LIPISMIES/OmaTyo_SYNTIKKA_MELODIA/HW/melodiasekvensseri.csv

Reference | Qty | Value | DNP | Exclude from BOM | Exclude from Board | Exclude from Simulation | Exclude from Position Files | Footprint | Datasheet
C1 | 1 | 10u |  |  |  |  | ${EXCLUDE_FROM_POS_FILES} | Capacitor_THT:CP_Radial_D5.0mm_P2.00mm
C3,C6,C9,C10,C13,C14,C15 | 7 | 100n |  |  |  |  | ${EXCLUDE_FROM_POS_FILES} | Capacitor_THT:C_Disc_D5.0mm_W2.5mm_P5.00mm
C5 | 1 | 330n |  |  |  |  | ${EXCLUDE_FROM_POS_FILES} | Capacitor_THT:C_Disc_D5.0mm_W2.5mm_P5.00mm
C7,C8 | 2 | 10u |  |  |  |  | ${EXCLUDE_FROM_POS_FILES} | Capacitor_THT:C_Disc_D5.0mm_W2.5mm_P5.00mm
C11,C12 | 2 | 10n |  |  |  |  | ${EXCLUDE_FROM_POS_FILES} | Capacitor_THT:C_Disc_D5.0mm_W2.5mm_P5.00mm
D1 | 1 | 1N5817 |  |  |  |  | ${EXCLUDE_FROM_POS_FILES} | Diode_THT:D_DO-41_SOD81_P10.16mm_Horizontal | http://www.vishay.com/docs/88525/1n5817.pdf
D3 | 1 | 1N4733A |  |  |  |  | ${EXCLUDE_FROM_POS_FILES} | Diode_THT:D_DO-41_SOD81_P10.16mm_Horizontal | https://www.vishay.com/docs/85816/1n4728a.pdf
DAC1 | 1 | MCP4821-E_P |  |  |  |  | ${EXCLUDE_FROM_POS_FILES} | Project_Libraries:DIP794W53P254L959H508Q8N | https://componentsearchengine.com/Datasheets/2/MCP4821-E_P.pdf
IC1 | 1 | 74LS138 |  |  |  |  | ${EXCLUDE_FROM_POS_FILES} | Package_DIP:DIP-16_W7.62mm | http://www.ti.com/lit/gpn/sn74LS138
J1 | 1 | Conn_02x05_Odd_Even |  |  |  | Excluded from simulation | ${EXCLUDE_FROM_POS_FILES} | Connector_IDC:IDC-Header_2x05_P2.54mm_Vertical
J2 | 1 | Clock_In |  |  |  |  | ${EXCLUDE_FROM_POS_FILES} | Project_Libraries:Adafruit_BBF_3_5mm_Mono_Jack
J3 | 1 | Gate_Out |  |  |  |  | ${EXCLUDE_FROM_POS_FILES} | Project_Libraries:Adafruit_BBF_3_5mm_Mono_Jack
J4 | 1 | CV_Out |  |  |  |  | ${EXCLUDE_FROM_POS_FILES} | Project_Libraries:Adafruit_BBF_3_5mm_Mono_Jack
J5 | 1 | Conn_02x03_Odd_Even |  |  |  |  | ${EXCLUDE_FROM_POS_FILES} | Connector_PinHeader_2.54mm:PinHeader_2x03_P2.54mm_Vertical
J6 | 1 | Conn_01x04 |  |  |  |  | ${EXCLUDE_FROM_POS_FILES} | Connector_PinHeader_2.54mm:PinHeader_1x04_P2.54mm_Vertical
MC1 | 1 | ATmega328P-P |  |  |  |  | ${EXCLUDE_FROM_POS_FILES} | Package_DIP:DIP-28_W7.62mm | http://ww1.microchip.com/downloads/en/DeviceDoc/ATmega328_P%20AVR%20MCU%20with%20picoPower%20Technology%20Data%20Sheet%2040001984A.pdf
R1,R8 | 2 | 10 |  |  |  |  | ${EXCLUDE_FROM_POS_FILES} | Resistor_THT:R_Axial_DIN0207_L6.3mm_D2.5mm_P10.16mm_Horizontal
R3 | 1 | 330 |  |  |  |  | ${EXCLUDE_FROM_POS_FILES} | Resistor_THT:R_Axial_DIN0207_L6.3mm_D2.5mm_P10.16mm_Horizontal
R4,R5,R6 | 3 | 1k |  |  |  |  | ${EXCLUDE_FROM_POS_FILES} | Resistor_THT:R_Axial_DIN0207_L6.3mm_D2.5mm_P10.16mm_Horizontal
R7 | 1 | 10k |  |  |  |  | ${EXCLUDE_FROM_POS_FILES} | Resistor_THT:R_Axial_DIN0207_L6.3mm_D2.5mm_P10.16mm_Horizontal
RE1 | 1 | EC11E15244B2 |  |  |  |  | ${EXCLUDE_FROM_POS_FILES} | Project_Libraries:EC11E15244B2 | https://tech.alpsalpine.com/e/products/detail/EC11E15244B2/
REG1 | 1 | LM78M05 |  |  |  |  | ${EXCLUDE_FROM_POS_FILES} | Package_TO_SOT_THT:TO-220-3_Vertical | https://www.onsemi.com/pub/Collateral/MC78M00-D.PDF
REG2 | 1 | MCP1700-5002E_TO |  |  |  |  | ${EXCLUDE_FROM_POS_FILES} | Project_Libraries:TO127P254X495-3
S1,S2,S3,S4,S5,S6,S7,S8 | 8 | TL1265RQSCLR |  |  |  |  | ${EXCLUDE_FROM_POS_FILES} | Project_Libraries:TL1265RQSCLR | https://configured-product-images.s3.amazonaws.com/2D/specs/TL1275CA2WA500QPB.pdf
S9 | 1 | TS02-66-140-BK-160-LCR-D |  |  |  |  | ${EXCLUDE_FROM_POS_FILES} | Project_Libraries:TS0266100BK100LCRD | https://www.sameskydevices.com/product/resource/ts02.pdf
TP_12V1,TP_A5V1,TP_D5V1,TP_DGND1 | 4 | TestPoint |  |  |  |  | ${EXCLUDE_FROM_POS_FILES} | TestPoint:TestPoint_Pad_2.0x2.0mm
TP_AGND1,TP_CV_OUT1 | 2 | TestPoint |  |  |  |  | ${EXCLUDE_FROM_POS_FILES} | TestPoint:TestPoint_THTPad_2.0x2.0mm_Drill1.0mm
U1 | 1 | TLV2372IP |  |  |  |  | ${EXCLUDE_FROM_POS_FILES} | Project_Libraries:DIP794W53P254L959H508Q8N | https://datasheet.datasheetarchive.com/originals/distributors/Datasheets-SFU2/DSASFU100032270.pdf
VR1 | 1 | 3296W-1-103 |  |  |  |  | ${EXCLUDE_FROM_POS_FILES} | Project_Libraries:3296W1103 | https://www.bourns.com/data/global/pdfs/3296.pdf
VR2 | 1 | PTV09A-4025F-B103 |  |  |  |  | ${EXCLUDE_FROM_POS_FILES} | Project_Libraries:PTV09A4025FB103 | https://www.bourns.com/docs/Product-Datasheets/PTV09.pdf
