LIPISMIES/OmaTyo_SYNTIKKA_MELODIA/HW/Front_Panel_v1.stl

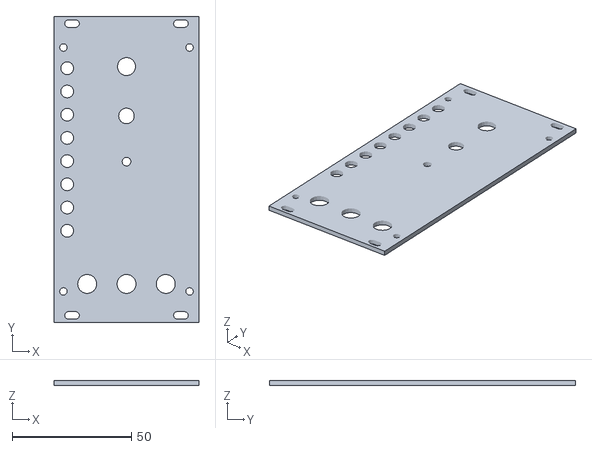
[picture p1: CAD file, 2026-10-16]
HW/Front_Panel_v1.stl
60.7 x 128.5 x 2.00
