LIPISMIES/OmaTyo_SYNTIKKA_MELODIA/HW/Project_Libraries/3D_Models/3296W-1-103.stp

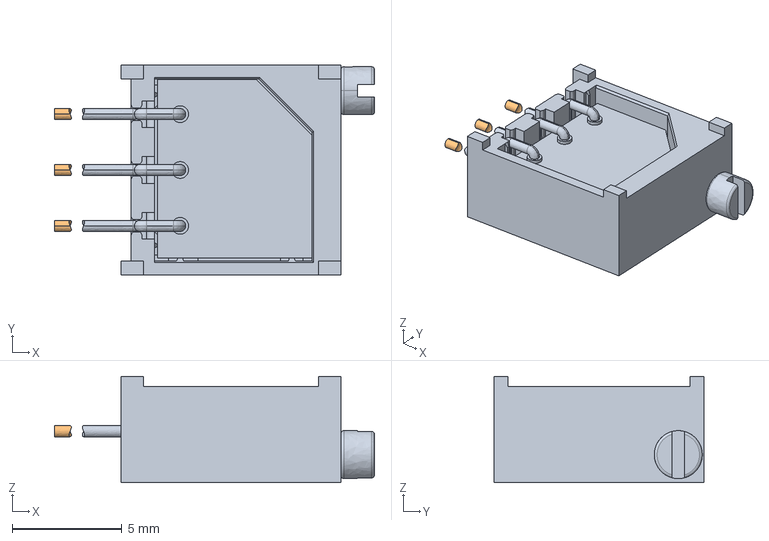
[picture p2: CAD file, 2026-10-11]
HW/Project_Libraries/3D_Models/3296W-1-103.stp
14.6 x 9.55 x 4.83 mm
