LIPISMIES/OmaTyo_SYNTIKKA_MELODIA/HW/Project_Libraries/EC11E15244B2.stp

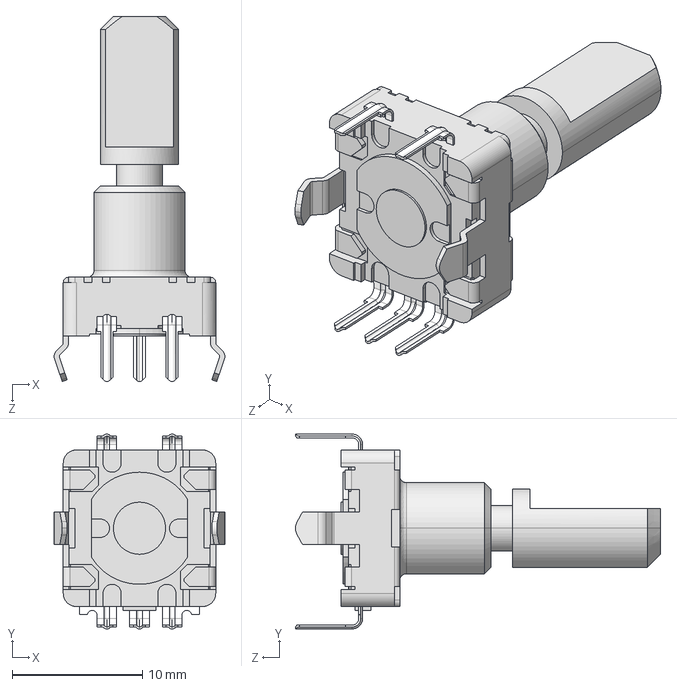
[picture p3: CAD file, 2026-10-11]
HW/Project_Libraries/EC11E15244B2.stp
13.1 x 15.0 x 28.0 mm
