LIPISMIES/OmaTyo_SYNTIKKA_MELODIA/HW/melodiasekvensseri.step

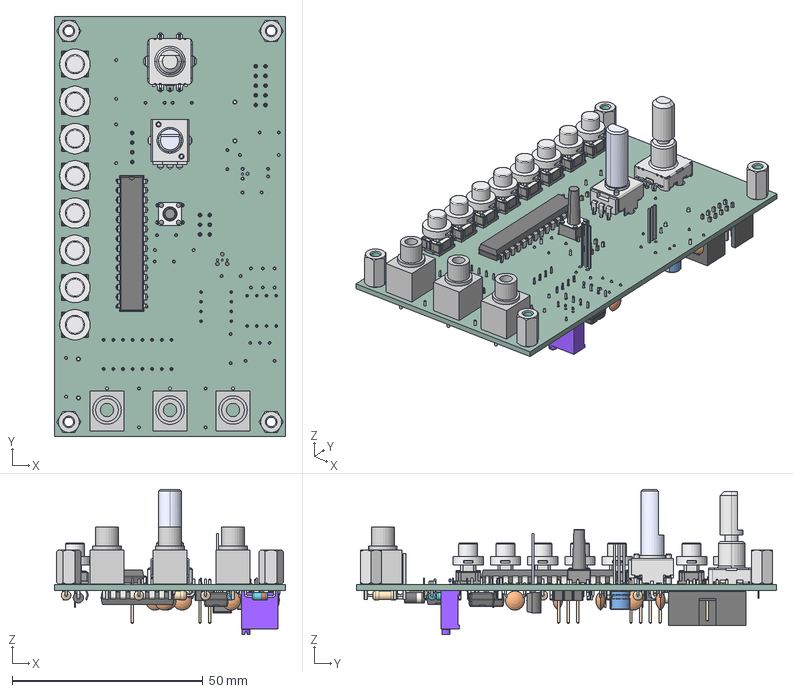
[picture p4: CAD file, 2026-10-13]
HW/melodiasekvensseri.step
60.6 x 110.0 x 38.1 mm
TL1265 Housing x 8
TL1265 Plunger x 8
TL1265 Cover x 8
TL1265 TWIST LED x 8
TL1265 S Cap Clear x 8
adafruitjack v1 x 3
EC11E-15SW
DIP-28_W7.62mm
CUI_DEVICES_TS02-66-140-BK-160-LCR-D
R_Axial_DIN0207_L63mm_D25mm_P1016mm_Horizontal x 7
IDC_Header_2x05_P254mm_Vertical
C_Disc_D50mm_W25mm_P500mm x 11
D_DO-35_SOD27_P7.62mm_Horizontal x 2
TS110-7A1-AP_Bulk Pack (Straight)
STMicro Logo
DIP-16_W7.62mm
BODY_P0008A x 2
LEAD_P0008A x 8
LD_LHALF_P0008A x 4
LD_RHALF_P0008A x 4
D_DO-41_SOD81_P10.16mm_Horizontal x 2
PinHeader_1x04_P254mm_Vertical
3296w-1-503lf_1
3296w-1-503lf_2
3296w-1-503lf_3
3296w-1-503lf_4
PinHeader_2x03_P254mm_Vertical
CP_Radial_D50mm_P200mm
2N7000-G
melodiasekvensseri_PCB
