LIPISMIES/OmaTyo_SYNTIKKA_MELODIA/HW/Project_Libraries/3D_Models/L78L05ACZ.stp

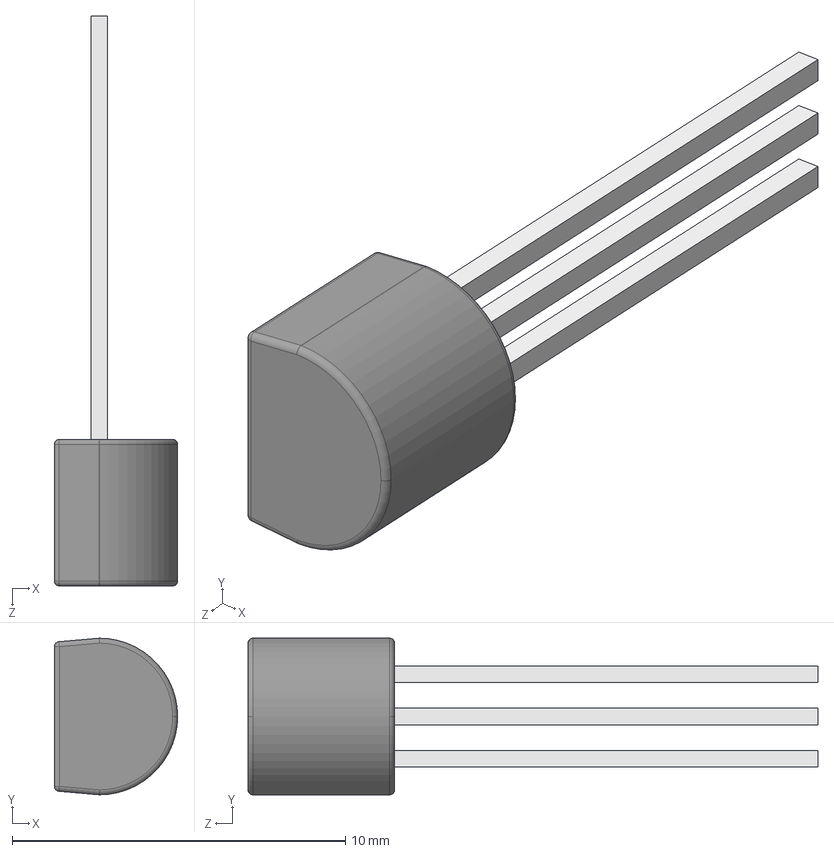
[picture p5: CAD file, 2026-10-11]
HW/Project_Libraries/3D_Models/L78L05ACZ.stp
3.70 x 4.70 x 17.1 mm
TS110-7A1-AP_Bulk Pack (Straight)
STMicro Logo
