LIPISMIES/OmaTyo_SYNTIKKA_MELODIA/HW/Project_Libraries/3D_Models/TS02-66-140-BK-160-LCR-D.stp

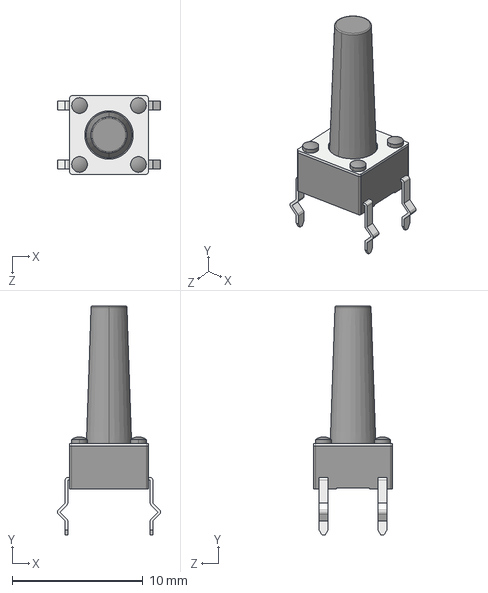
[picture p6: CAD file, 2026-10-11]
HW/Project_Libraries/3D_Models/TS02-66-140-BK-160-LCR-D.stp
7.90 x 17.5 x 6.00 mm
