LIPISMIES/OmaTyo_SYNTIKKA_MELODIA/HW/Project_Libraries/3D_Models/PTV09A-4025F-B103.stp

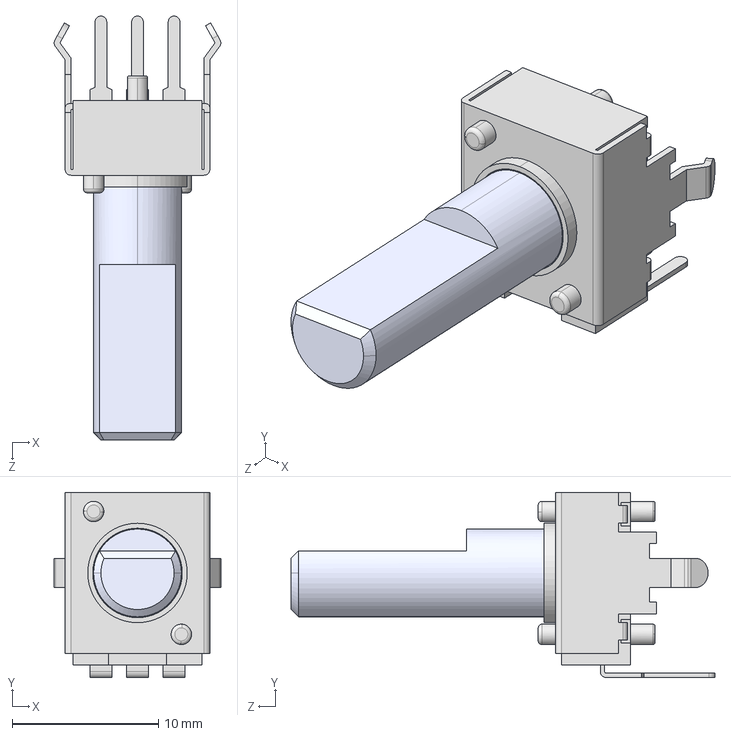
[picture p7: CAD file, 2026-10-11]
HW/Project_Libraries/3D_Models/PTV09A-4025F-B103.stp
11.4 x 12.7 x 29.0 mm
