LIPISMIES/OmaTyo_SYNTIKKA_MELODIA/HW/Project_Libraries/3D_Models/Download_STEP_970090324+(rev1).stp

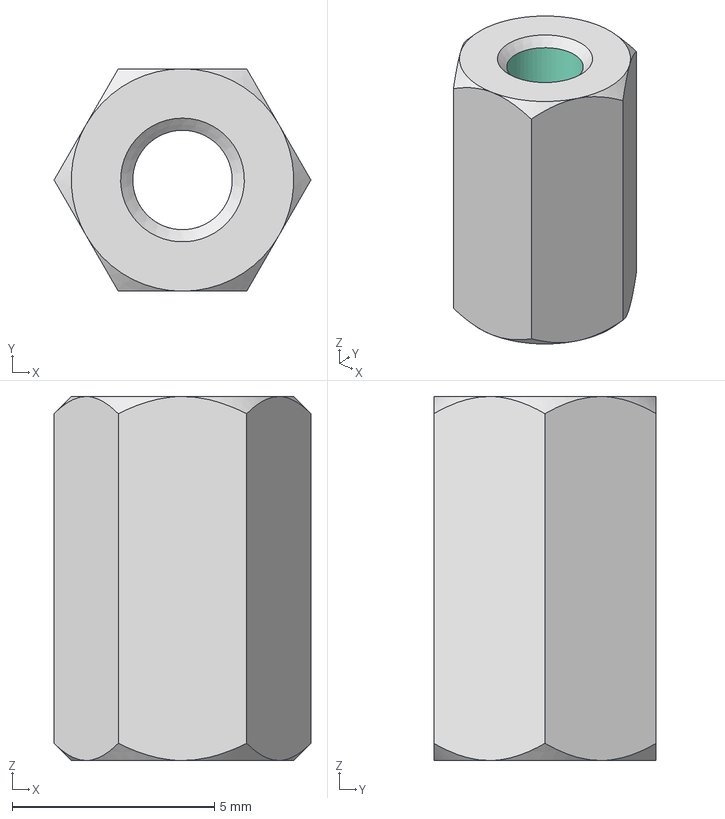
[picture p8: CAD file, 2026-10-11]
HW/Project_Libraries/3D_Models/Download_STEP_970090324+(rev1).stp
6.35 x 5.50 x 9.00 mm
