LIPISMIES/OmaTyo_SYNTIKKA_MELODIA/HW/Project_Libraries/3D_Models/MCP4821-E_P.stp

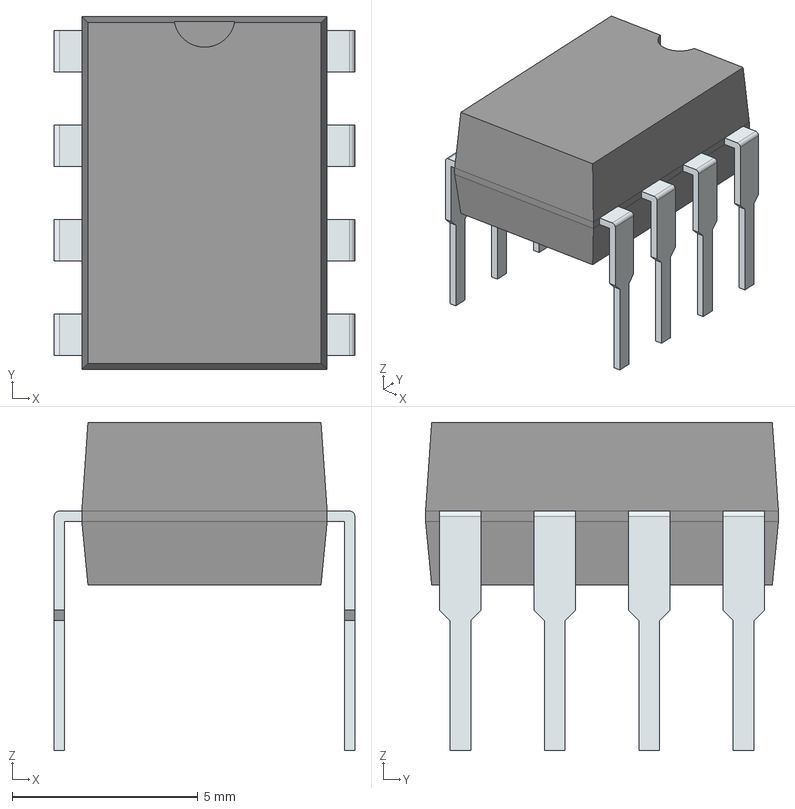
[picture p9: CAD file, 2026-10-11]
HW/Project_Libraries/3D_Models/MCP4821-E_P.stp
8.09 x 9.50 x 8.83 mm
PinsArrayLR
