LIPISMIES/OmaTyo_SYNTIKKA_MELODIA/HW/Project_Libraries/3D_Models/TL1265xQSxxx.stp

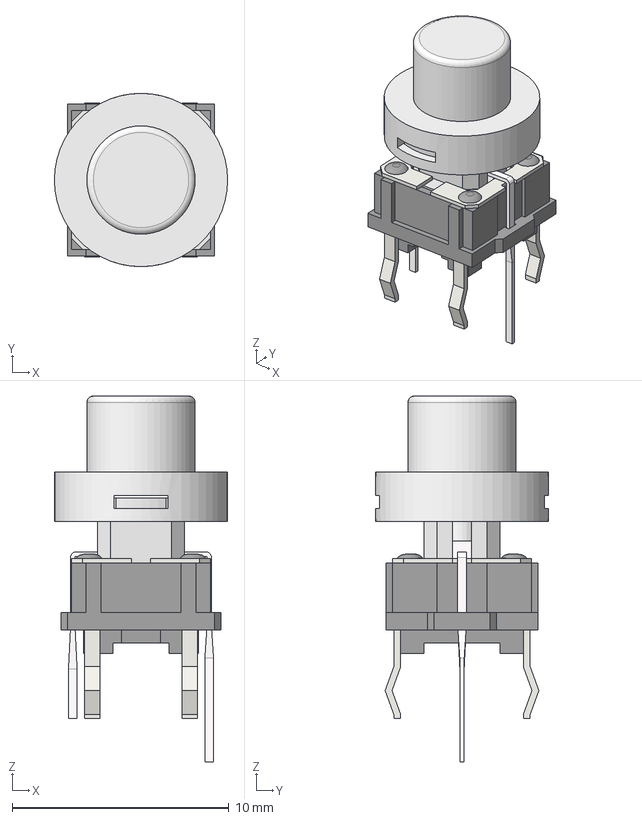
[picture p10: CAD file, 2026-10-11]
HW/Project_Libraries/3D_Models/TL1265xQSxxx.stp
8.00 x 8.00 x 16.9 mm
TL1265 Housing
TL1265 Plunger
TL1265 Cover
TL1265 TWIST LED
TL1265 S Cap Clear
