LIPISMIES/OmaTyo_SYNTIKKA_MELODIA/HW/Project_Libraries/3D_Models/adafruitjack.step

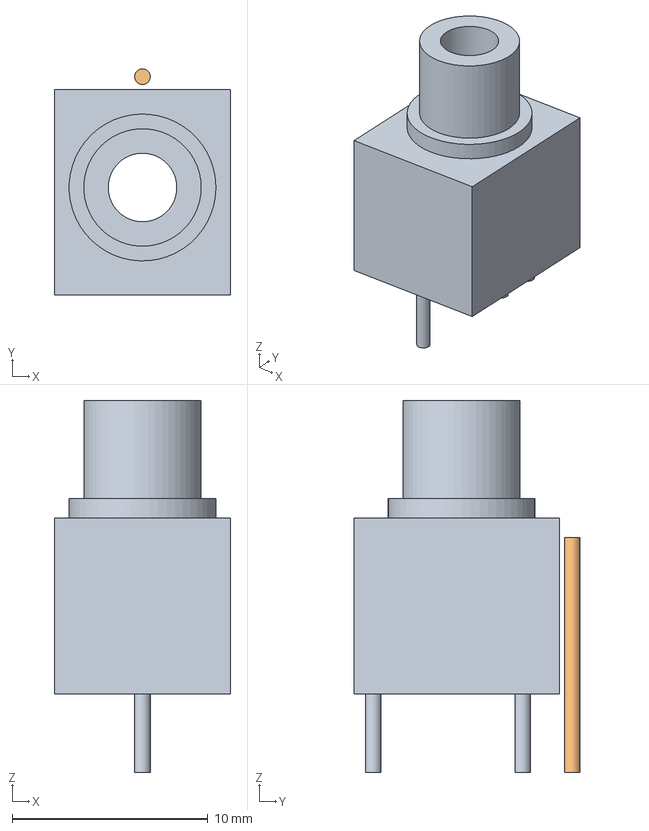
[picture p11: CAD file, 2026-10-11]
HW/Project_Libraries/3D_Models/adafruitjack.step
9.00 x 11.6 x 19.0 mm
