LIPISMIES/OmaTyo_SYNTIKKA_MELODIA/HW/Project_Libraries/3D_Models/TL1265RQSCLR.stp

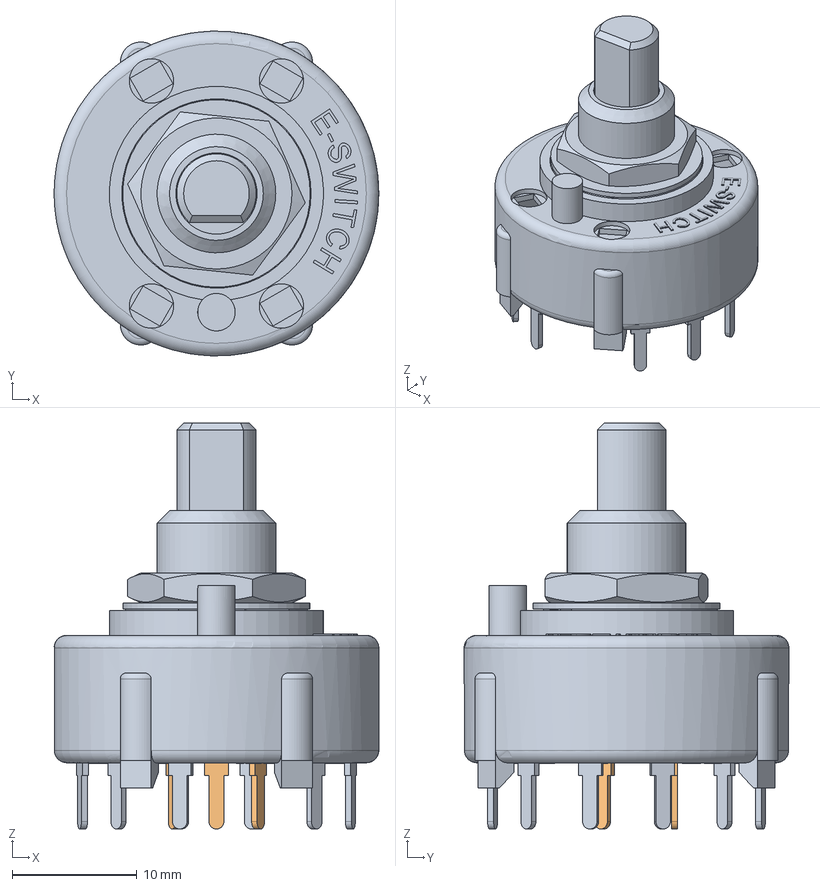
[picture p12: CAD file, 2026-10-11]
HW/Project_Libraries/3D_Models/TL1265RQSCLR.stp
26.0 x 26.0 x 32.5 mm
