LIPISMIES/OmaTyo_SYNTIKKA_MELODIA/HW/melodiasekvensseri.kicad_pcb

## KiCad design HW/melodiasekvensseri.kicad_pcb (2026-10-23)

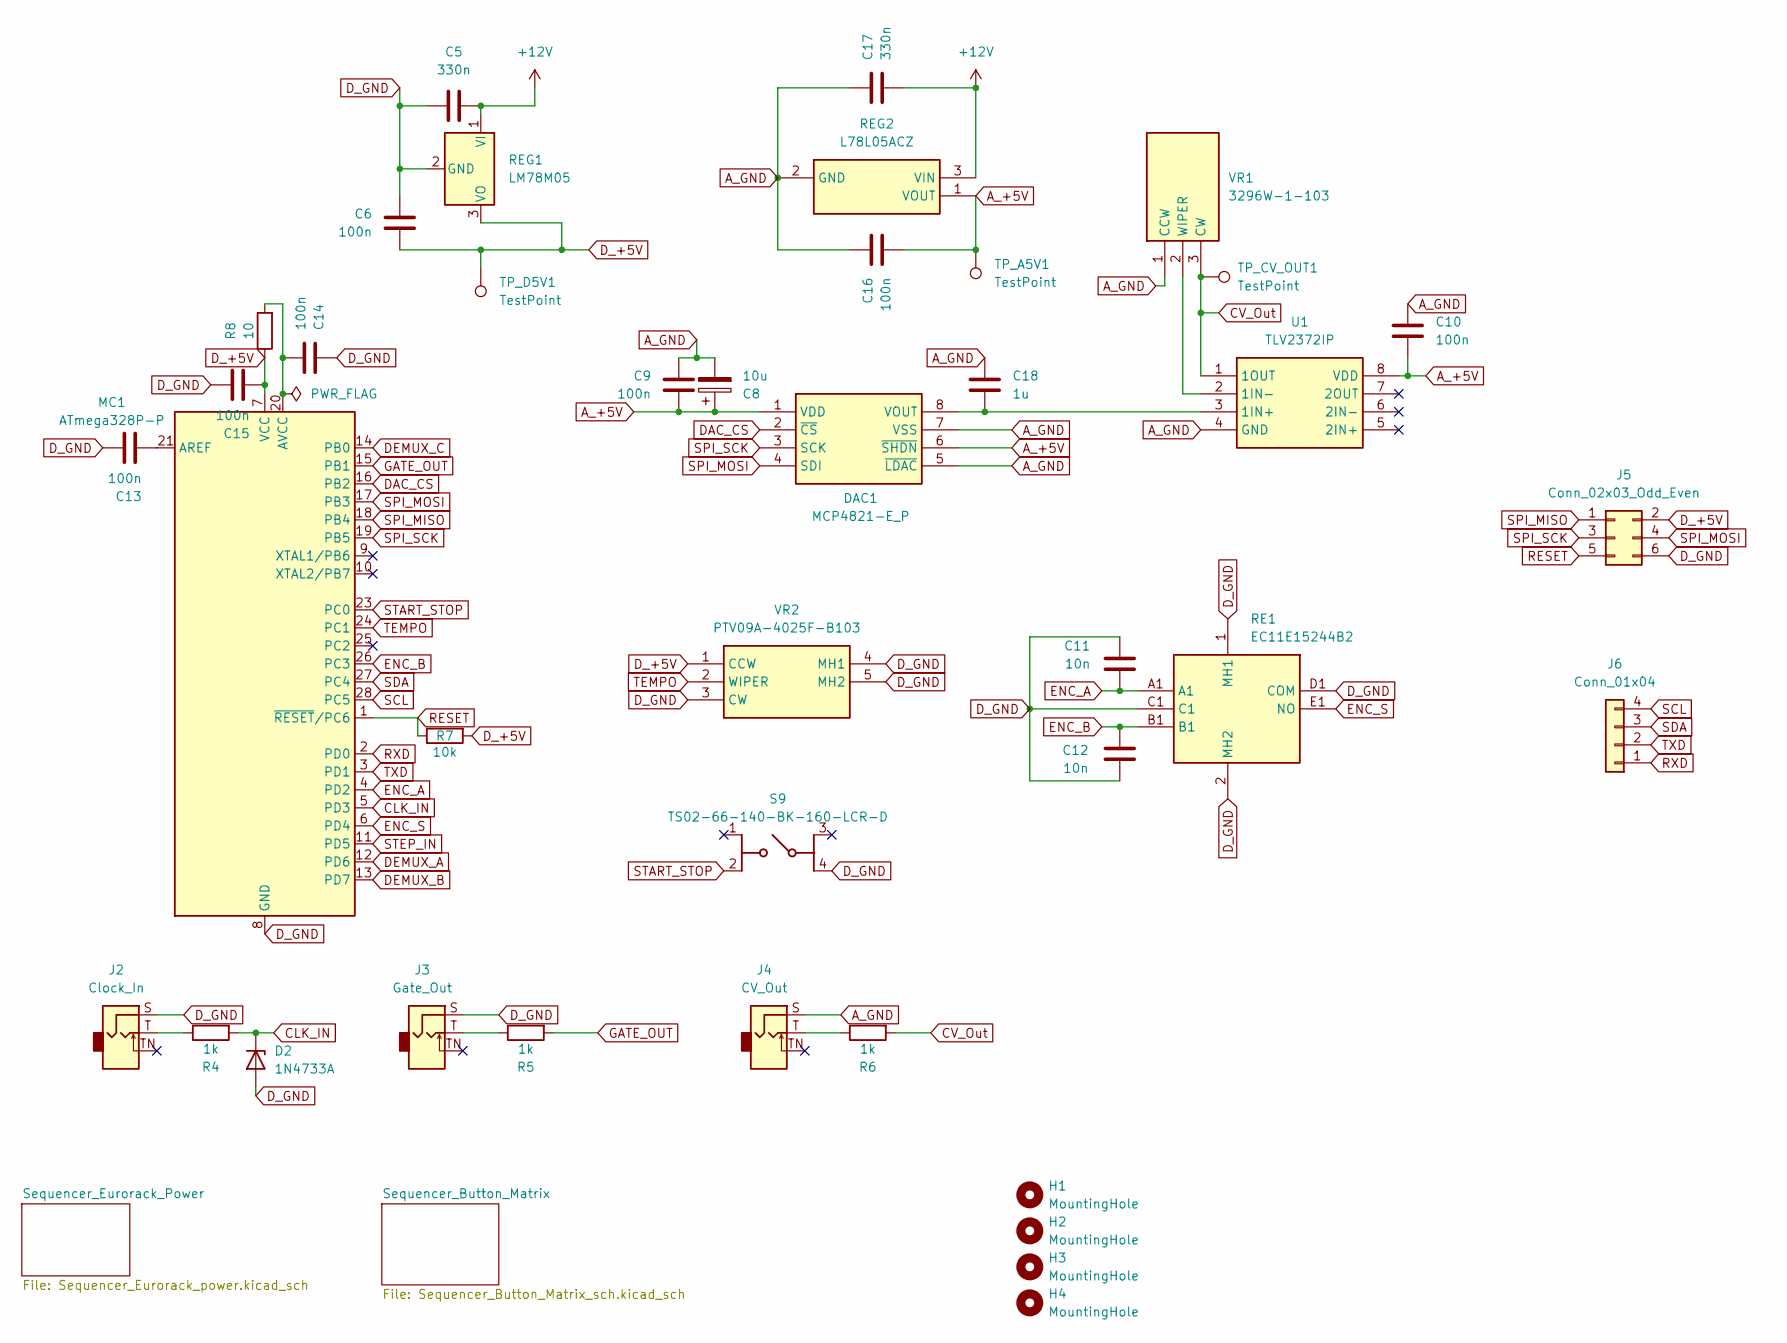
[picture p13: schematic melodiasekvensseri.kicad_sch]

Parts:
C5, C17: 330n; C_Disc_D5.0mm_W2.5mm_P5.00mm
C6, C9, C10, C13, C14, C15, C16: 100n; C_Disc_D5.0mm_W2.5mm_P5.00mm
C8: 10u; C_Disc_D5.0mm_W2.5mm_P5.00mm
C11, C12: 10n; C_Disc_D5.0mm_W2.5mm_P5.00mm
C18: 1u; C_Disc_D5.0mm_W2.5mm_P5.00mm
D2: 1N4733A; D_DO-41_SOD81_P10.16mm_Horizontal
DAC1: MCP4821-E_P; DIP794W53P254L959H508Q8N; Mouser Part Number 579-MCP4821-E/P
H1, H2, H3, H4: MountingHole; MountingHole_3.2mm_M3
J2: Clock_In; Adafruit_BBF_3_5mm_Mono_Jack
J3: Gate_Out; Adafruit_BBF_3_5mm_Mono_Jack
J4: CV_Out; Adafruit_BBF_3_5mm_Mono_Jack
J5: Conn_02x03_Odd_Even; PinHeader_2x03_P2.54mm_Vertical
J6: Conn_01x04; PinHeader_1x04_P2.54mm_Vertical
MC1: ATmega328P-P; DIP-28_W7.62mm
R4, R5, R6: 1k; Resistor_SMD+THTuniversal_0805to1206_RM10_HandSoldering_Rev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
R7: 10k; R_Axial_DIN0207_L6.3mm_D2.5mm_P10.16mm_Horizontal
R8: 10; R_Axial_DIN0207_L6.3mm_D2.5mm_P10.16mm_Horizontal
RE1: EC11E15244B2; Mouser Part Number 688-EC11E15244B2
REG1: LM78M05; TO-220-3_Vertical; Mouser Part Number 511-L78L05ACZ
REG2: L78L05ACZ; Mouser Part Number 511-L78L05ACZ
S9: TS02-66-140-BK-160-LCR-D; TS0266100BK100LCRD; Mouser Part Number 179-TS0266140BK160LC
TP_A5V1: TestPoint; TestPoint_THTPad_1.5x1.5mm_Drill0.7mm
TP_CV_OUT1: TestPoint; TestPoint_THTPad_1.5x1.5mm_Drill0.7mm
TP_D5V1: TestPoint; TestPoint_THTPad_1.5x1.5mm_Drill0.7mm
U1: TLV2372IP; DIP794W53P254L959H508Q8N; Mouser Part Number 595-TLV2372IP
VR1: 3296W-1-103; 3296W1103; Mouser Part Number 652-3296W-1-103
VR2: PTV09A-4025F-B103; PTV09A4025FB103; Mouser Part Number 652-PTV09A-4025FB103

Connections:
+12V: C5.2, C17.2, REG1.1 (VI), REG2.3 (VIN); also elsewhere on the board
A_+5V: C8.1, C9.2, C10.2, C16.2, DAC1.1 (VDD), DAC1.6 (~SHDN), REG2.1 (VOUT), TP_A5V1.1 (1_1), U1.8 (VDD)
A_GND: C8.2, C9.1, C10.1, C16.1, C17.1, C18.1, DAC1.5 (~LDAC), DAC1.7 (VSS), J4.S, REG2.2 (GND), U1.4 (GND), VR1.1 (CCW); also elsewhere on the board
CLK_IN: D2.1 (K), MC1.5 (PD3), R4.2
CV_Out: R6.2, TP_CV_OUT1.1 (1_1), U1.1 (1OUT), VR1.3 (CW)
DAC_CS: DAC1.2 (~CS), MC1.16 (PB2)
DEMUX_A: MC1.12 (PD6); also elsewhere on the board
DEMUX_B: MC1.13 (PD7); also elsewhere on the board
DEMUX_C: MC1.14 (PB0); also elsewhere on the board
D_+5V: C6.2, C15.2, J5.2, MC1.7 (VCC), R7.2, R8.1, REG1.3 (VO), TP_D5V1.1 (1_1), VR2.1 (CCW); also elsewhere on the board
D_GND: C5.1, C6.1, C11.1, C12.2, C13.1, C14.1, C15.1, D2.2 (A), J2.S, J3.S, J5.6, MC1.8 (GND), MC1.22 (GND), RE1.1 (MH1), RE1.2 (MH2), RE1.C1, RE1.D1 (COM), REG1.2 (GND), S9.4 (COM_2), VR2.3 (CW), VR2.4 (MH1), VR2.5 (MH2); also elsewhere on the board
ENC_A: C11.2, MC1.4 (PD2), RE1.A1
ENC_B: C12.1, MC1.26 (PC3), RE1.B1
ENC_S: MC1.6 (PD4), RE1.E1 (NO)
GATE_OUT: MC1.15 (PB1), R5.2
unnamed: C18.2, DAC1.8 (VOUT), U1.3 (1IN+)
unnamed: J2.T, R4.1
unnamed: J3.T, R5.1
unnamed: J4.T, R6.1
unnamed: C13.2, MC1.21 (AREF)
unnamed: C14.2, MC1.20 (AVCC), R8.2
unnamed: U1.2 (1IN-), VR1.2 (WIPER)
RESET: J5.5, MC1.1 (~RESET/PC6), R7.1
RXD: J6.1, MC1.2 (PD0)
SCL: J6.4, MC1.28 (PC5)
SDA: J6.3, MC1.27 (PC4)
SPI_MISO: J5.1, MC1.18 (PB4)
SPI_MOSI: DAC1.4 (SDI), J5.4, MC1.17 (PB3)
SPI_SCK: DAC1.3 (SCK), J5.3, MC1.19 (PB5)
START_STOP: MC1.23 (PC0), S9.2 (NO_2)
STEP_IN: MC1.11 (PD5); also elsewhere on the board
TEMPO: MC1.24 (PC1), VR2.2 (WIPER)
TXD: J6.2, MC1.3 (PD1)

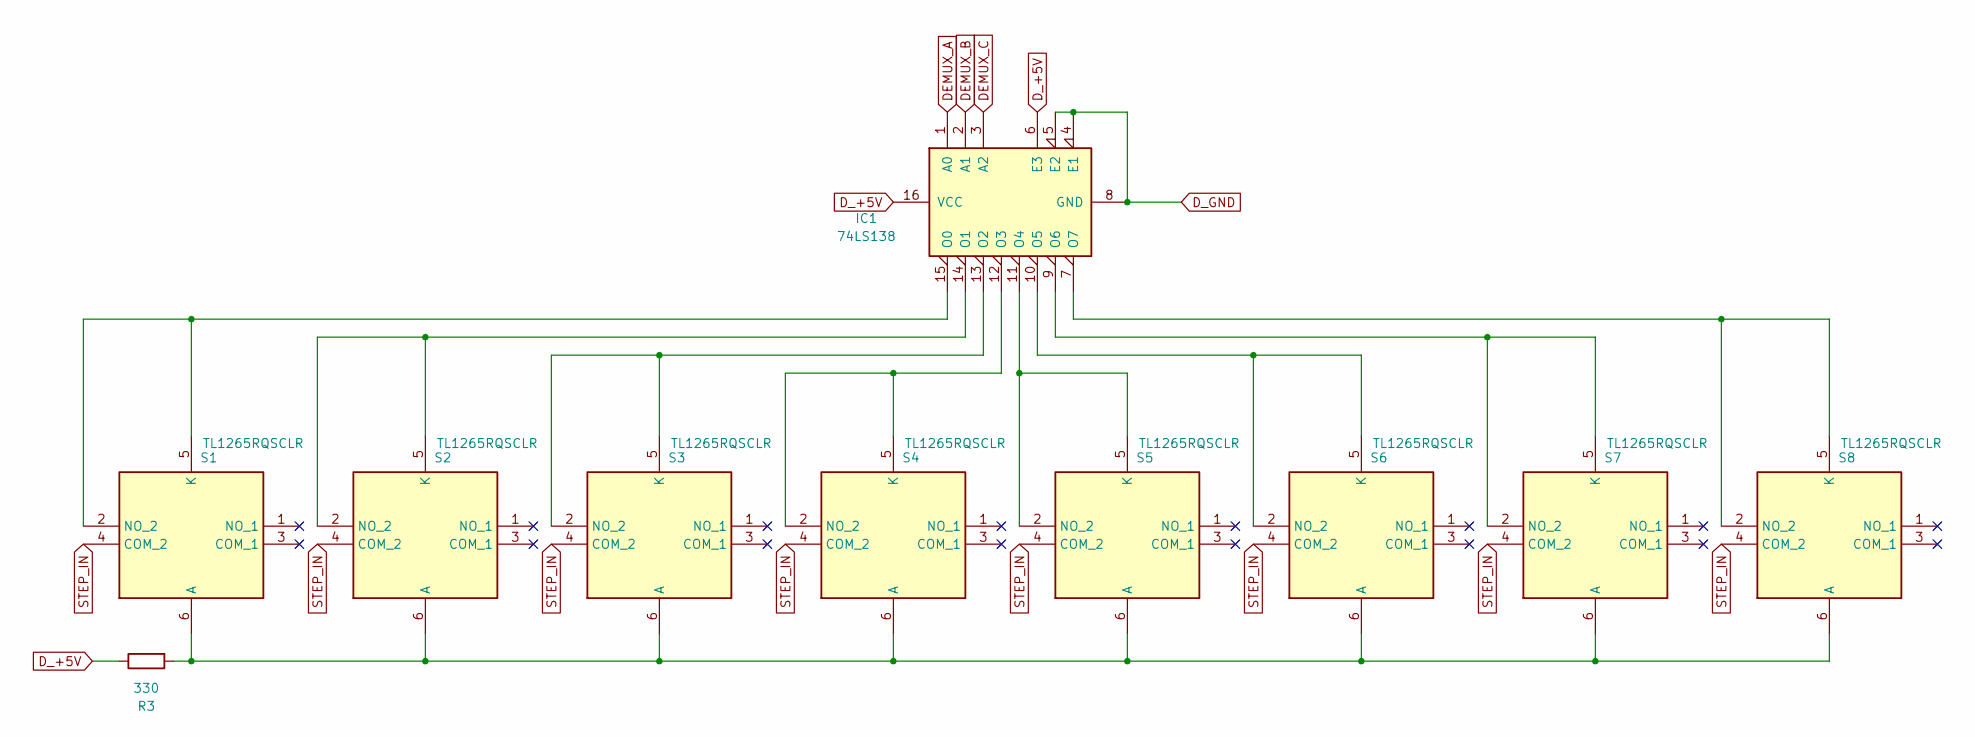
[picture p14: schematic Sequencer_Button_Matrix_sch.kicad_sch, Melodiasekvensseri]

Parts:
IC1: 74LS138; DIP-16_W7.62mm
R3: 330; R_Axial_DIN0207_L6.3mm_D2.5mm_P10.16mm_Horizontal
S1, S2, S3, S4, S5, S6, S7, S8: TL1265RQSCLR; Mouser Part Number 612-TL1265RQSCLR

Connections:
DEMUX_A: IC1.1 (A0); also elsewhere on the board
DEMUX_B: IC1.2 (A1); also elsewhere on the board
DEMUX_C: IC1.3 (A2); also elsewhere on the board
D_+5V: IC1.6 (E3), IC1.16 (VCC), R3.1; also elsewhere on the board
D_GND: IC1.4 (E1), IC1.5 (E2), IC1.8 (GND); also elsewhere on the board
unnamed: IC1.15 (O0), S1.2 (NO_2), S1.5 (K)
unnamed: IC1.14 (O1), S2.2 (NO_2), S2.5 (K)
unnamed: IC1.13 (O2), S3.2 (NO_2), S3.5 (K)
unnamed: IC1.12 (O3), S4.2 (NO_2), S4.5 (K)
unnamed: IC1.11 (O4), S5.2 (NO_2), S5.5 (K)
unnamed: IC1.10 (O5), S6.2 (NO_2), S6.5 (K)
unnamed: IC1.9 (O6), S7.2 (NO_2), S7.5 (K)
unnamed: IC1.7 (O7), S8.2 (NO_2), S8.5 (K)
unnamed: R3.2, S1.6 (A), S2.6 (A), S3.6 (A), S4.6 (A), S5.6 (A), S6.6 (A), S7.6 (A), S8.6 (A)
STEP_IN: S1.4 (COM_2), S2.4 (COM_2), S3.4 (COM_2), S4.4 (COM_2), S5.4 (COM_2), S6.4 (COM_2), S7.4 (COM_2), S8.4 (COM_2); also elsewhere on the board

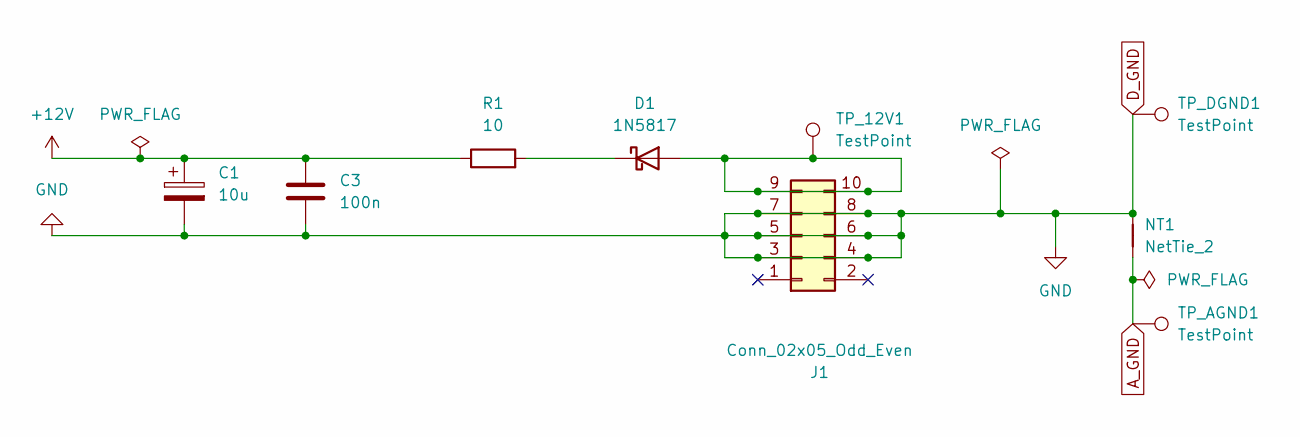
[picture p15: schematic Sequencer_Eurorack_power.kicad_sch, Melodiasekvensseri]

Parts:
C1: 10u; CP_Radial_D5.0mm_P2.00mm
C3: 100n; C_Disc_D5.0mm_W2.5mm_P5.00mm
D1: 1N5817; D_DO-41_SOD81_P10.16mm_Horizontal
J1: Conn_02x05_Odd_Even; IDC-Header_2x05_P2.54mm_Vertical
NT1: NetTie_2; NetTie-2_SMD_Pad2.0mm
R1: 10; Resistor_SMD+THTuniversal_0805to1206_RM10_HandSoldering_Rev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
TP_12V1: TestPoint; TestPoint_THTPad_1.5x1.5mm_Drill0.7mm
TP_AGND1: TestPoint; TestPoint_THTPad_1.5x1.5mm_Drill0.7mm
TP_DGND1: TestPoint; TestPoint_THTPad_1.5x1.5mm_Drill0.7mm

Connections:
+12V: C1.1, C3.1, R1.1; also elsewhere on the board
A_GND: NT1.1, TP_AGND1.1 (1_1); also elsewhere on the board
D_GND: C1.2, C3.2, J1.3, J1.4, J1.5, J1.6, J1.7, J1.8, NT1.2, TP_DGND1.1 (1_1); also elsewhere on the board
unnamed: D1.2 (A), J1.9, J1.10, TP_12V1.1 (1_1)
unnamed: D1.1 (K), R1.2

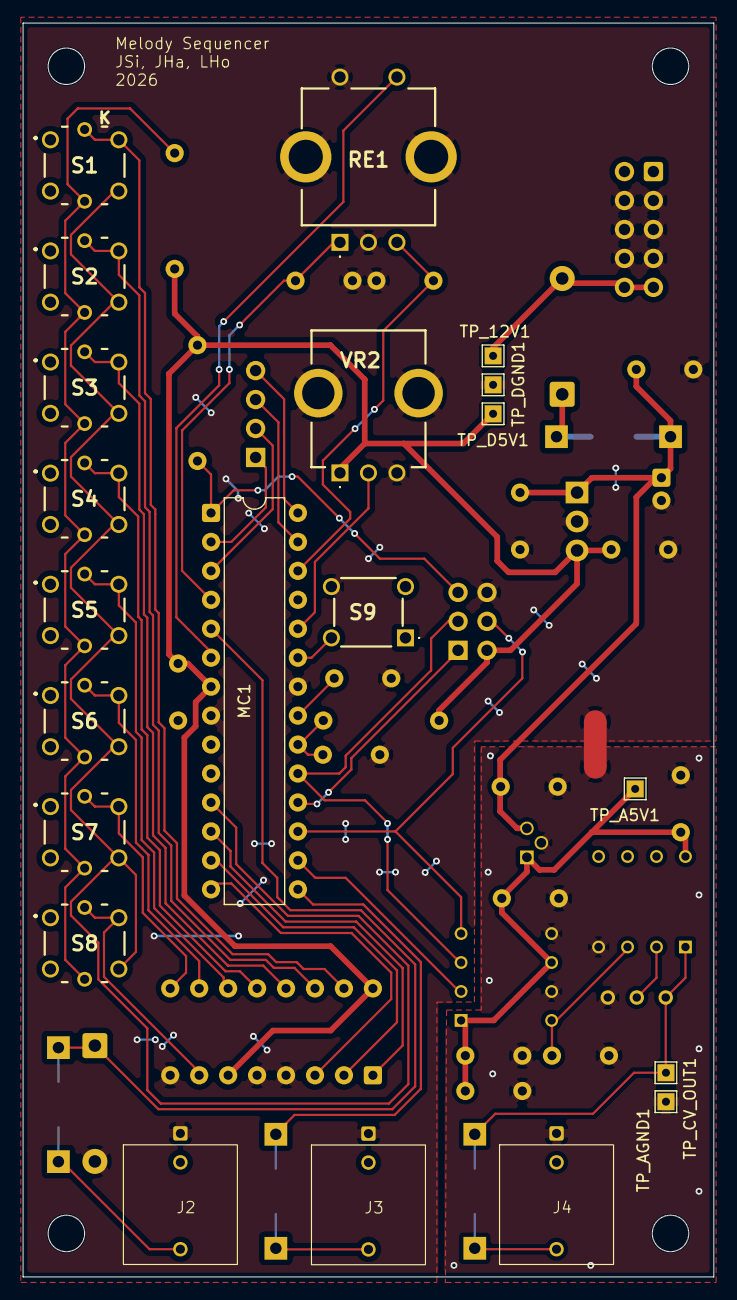
[picture p16: board melodiasekvensseri.kicad_pcb from above]

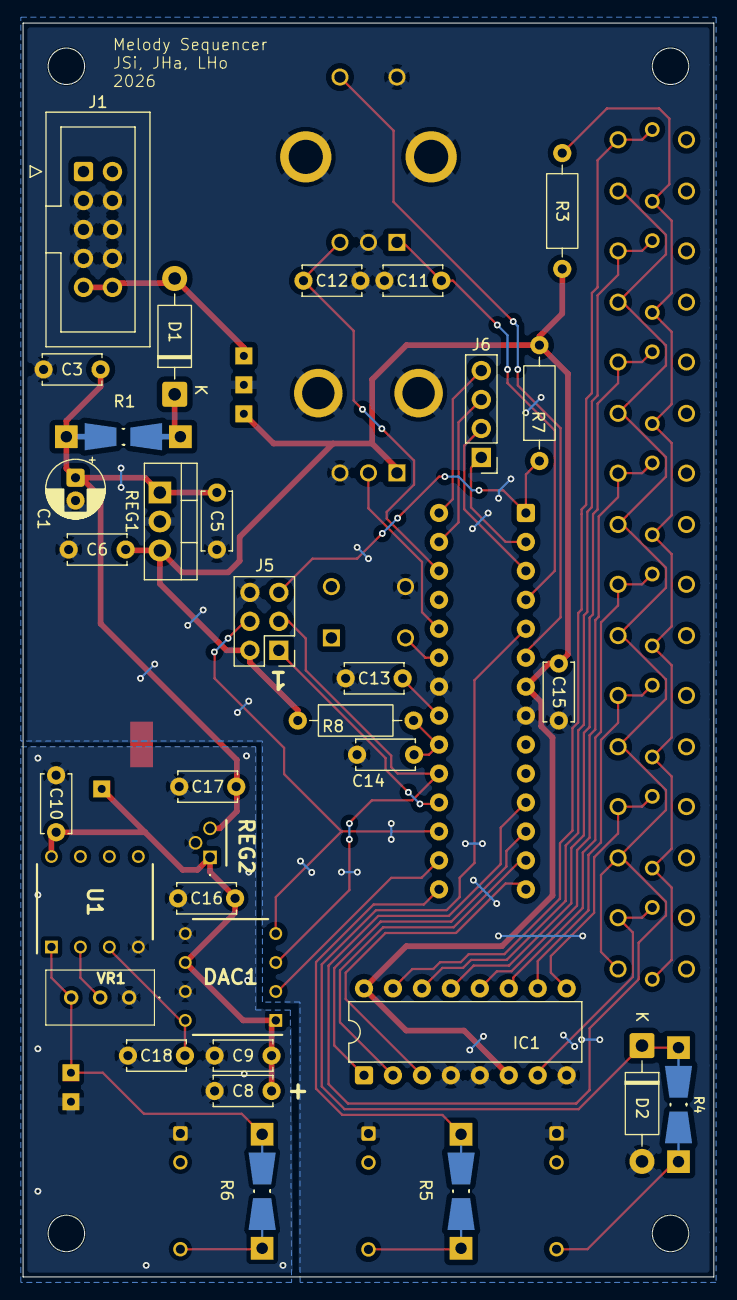
[picture p17: board melodiasekvensseri.kicad_pcb from below]

Board: 2 copper layers, 60.6 x 110.0 mm, 59 parts (33 on the bottom side), 44 nets.
