LIPISMIES/OmaTyo_SYNTIKKA_MELODIA/PlatformIO_test_project/Melody_sequencer_test_project/src/sequence.h

#pragma once

#include <stdint.h>

void sequenceBegin();
void sequenceUpdate(unsigned long now, bool externalClock, bool externalTick);
void sequenceApplyEncoderDelta(int8_t delta);
void sequenceSetTempoBpm(uint16_t bpm);
