LIPISMIES/OmaTyo_SYNTIKKA_MELODIA/(commit log)

2026-10-05 Arduino-kooditiedosto .ino
2026-10-13 Pin remapping, connect AVCC, filtering, TP
2026-10-16 Panel clearances, switched REG1, added test code
2026-10-20 Removed CV_OUT diodes, filtering cap added
2026-10-21 Some resistor footprints changed
2026-10-21 REG2 changed, grounding fixes, routing changes
2026-10-22 Cleanup traces
2026-10-22 Added ground via, small changes
